HexabitzPlatform/USB-FTDI/README.md

# USB-FTDI
Hexabitz 3.3V/0.5A USB to FTDI Cable Circuit Hardware Design
