HexabitzPlatform/USB-FTDI/Rleased/BOM/USB_FTDI.xlsx

 |  | www.hexabitz.com info@hexabitz.com |  | Bill Of Materials
Customer | Hexabitz | Revision | 1
Project | Hexabitz Kits | Date | 2024-08-31
Board | USB to FTDI with 3.3V/1A | Notes
Designator | Description | Manufacturer Part Number | Manufacturer | Octopart Url | Quantity
J1 | 4 Position 30 VAC 3 A USB Type A 2.0 Right Angle Receptacle USB Connector | USB1061-GF-L-A | GCT | https://octopart.com/usb1061-gf-l-a-global+connector+technology-51853460?r=sp | 1
C8 | CAP 50V 10nF KEMET Multilayer Ceramic Capacitors MLCC-SMD/ | C0603C103K5RACTU | KEMET | https://octopart.com/c0603c103k5ractu-kemet-133094?r=sp&s=R_iPBxLnSmGqhkU2rIMFpg | 1
C6, C7 , C9, C10 | CAP CER 0.1UF 25V X7R 0603 | CGA3E2X8R1E104K080AE | TDK | https://octopart.com/cga3e2x8r1e104k080ae-tdk-68305753?r=sp | 4
C3, C4 | Multilayer Ceramic Capacitor, 47 pF, 50 V, ± 5%, C0G (NP0), 0603 [1608 Metric] | CL10C470JB8NNNC | Samsung | https://octopart.com/cl10c470jb8nnnc-samsung-9299382?r=sp | 2
C2 | CAP CER 1 UF 16V X7R 0805 | CC0805KKX7R7BB105 | YAGEO [VA] | https://octopart.com/cc0805kkx7r7bb105-yageo-8376555?r=sp | 1
C5 | CAP CER 4.7UF 16V X7R 0805 | C0805C475K4RACTU | KEMET [VA] | https://octopart.com/c0805c475k4ractu-kemet-22859922?r=sp | 1
C1 | CAP CERAMIC TOR 100UF 6.3V X5R 20% 1210 | C3225X5R0J107M250AC | TDK | https://octopart.com/c3225x5r0j107m250ac-tdk-25947844?r=spc# | 1
R1, R2 | Thick Film Resistors - SMD 0603 27ohms 5% AEC-Q200 | ERJ-3GEYJ270V | Panasonic | https://octopart.com/erj-3geyj270v-panasonic-55422052?r=sp | 2
R3, R4 | Thick Film Resistors - SMD 0603 270 Ohm 5% Tol | ERJ-3GEYJ271V | Panasonic | https://octopart.com/erj-3geyj271v-panasonic-55560546?r=sp | 2
FB1 | Ferrite Beads Multi-Layer 30Ohm 25% 100MHz 1.5A 50mOhm DCR 0603 | MPZ1608S601ATD25 | TDK | https://octopart.com/search?q=MPZ1608S601ATD25&currency=USD&specs=0 | 1
RXLED | LED Uni-Color Soft Orange 611nm 2-Pin Chip 0603(1608Metric) T/R | VLMO1300-GS08 | Vishay | https://octopart.com/vlmo1300-gs08-vishay-21709200?r=sp# | 1
TXLED | LED Uni-Color Yellow 588nm 2-Pin Chip 0603(1608Metric) T/R | VLMY1300-GS08 | Vishay | https://octopart.com/vlmy1300-gs08-vishay-21709204?r=sp | 1
IC1 | USB Full Speed to Serial UART IC, Includes Oscillator and EEPROM - SSOP-28 | FT232RL-REEL | FTDI | https://octopart.com/ft232rl-reel-ftdi-19172117?r=sp | 1
U1 | Linear Voltage Regulator IC 1 Output 1A SOT-223-4 | LM3940IMP-3.3/NOPB | Texas Instruments | https://octopart.com/lm3940imp-3.3%2Fnopb-texas+instruments-24823014?r=sp | 1
