HexabitzPlatform/USB-FTDI/Documentation/USB_FTDI Schematic.pdf

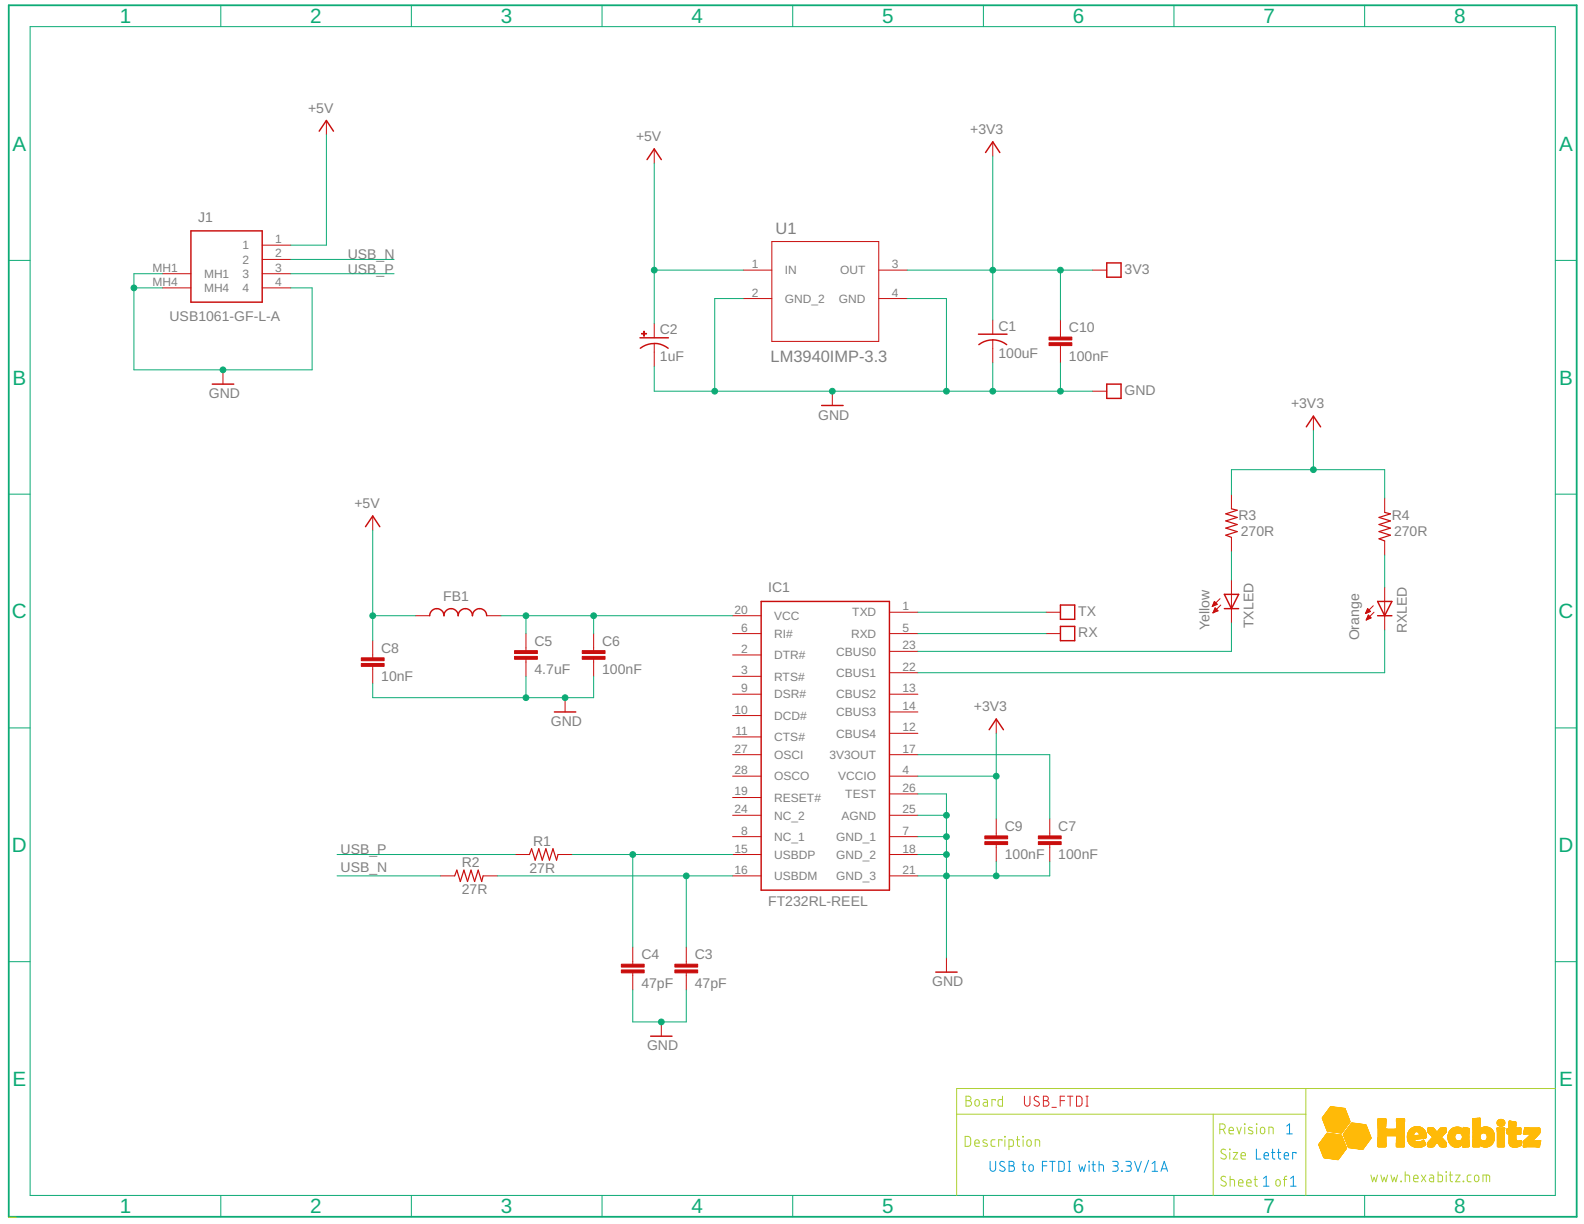
[picture p1: page 1]
