HexabitzPlatform/USB-FTDI/Design/USB_FTDI.brd

## EAGLE design Design/USB_FTDI.brd (2024-09-01)

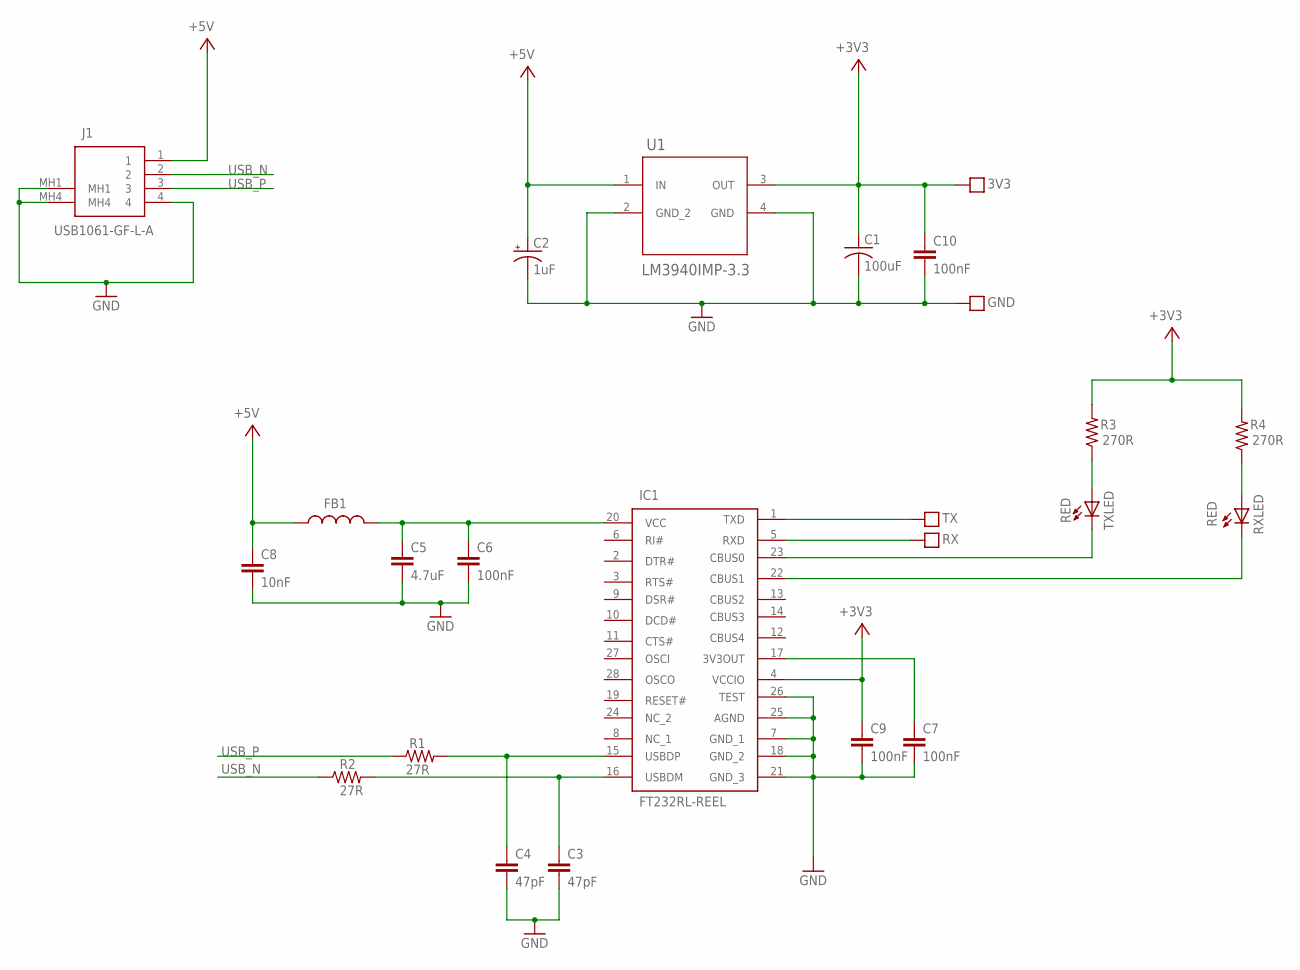
[picture p2: schematic USB_FTDI.sch]

Parts:
3V3: PAD5
C1: 100uF; C-1210
C2: 1uF; C-0805-POL
C3, C4: 47pF; C-0603
C5: 4.7uF; C-0805
C6, C7, C9, C10: 100nF; C-0603
C8: 10nF; C-0603
FB1: FB-0603
GND: PAD5
IC1: FT232RL-REEL; SOP65P778X200-28N
J1: USB1061-GF-L-A; USB1061GFLA
R1, R2: 27R; R-0603
R3, R4: 270R; R-0603
RX: PAD5
RXLED: RED; VLMS1300-GS08
TX: PAD5
TXLED: RED; VLMS1300-GS08
U1: LM3940IMP-3.3; SOT230P696X180-4N

Connections:
+3V3: 3V3.P$1, 3V3.P$2, C1.1, C9.1, C10.1, IC1.4 (VCCIO), R3.2, R4.2, U1.3 (OUT)
+5V: C2.1 (+), C8.1, FB1.1, J1.1, U1.1 (IN)
GND: C1.2, C2.2 (-), C3.2, C4.2, C5.2, C6.2, C7.2, C8.2, C9.2, C10.2, GND.P$1, GND.P$2, IC1.7 (GND_1), IC1.18 (GND_2), IC1.21 (GND_3), IC1.25 (AGND), IC1.26 (TEST), J1.4, J1.MH1, J1.MH4, U1.2 (GND_2), U1.4 (GND)
unnamed: R4.1, RXLED.A
unnamed: R3.1, TXLED.A
unnamed: IC1.1 (TXD), TX.P$1, TX.P$2
unnamed: IC1.5 (RXD), RX.P$1, RX.P$2
unnamed: C5.1, C6.1, FB1.2, IC1.20 (VCC)
unnamed: IC1.23 (CBUS0), TXLED.C
unnamed: IC1.22 (CBUS1), RXLED.C
unnamed: C7.1, IC1.17 (3V3OUT)
USBF_N: C3.1, IC1.16 (USBDM), R2.2
USBF_P: C4.1, IC1.15 (USBDP), R1.2
USB_N: J1.2, R2.1
USB_P: J1.3, R1.1

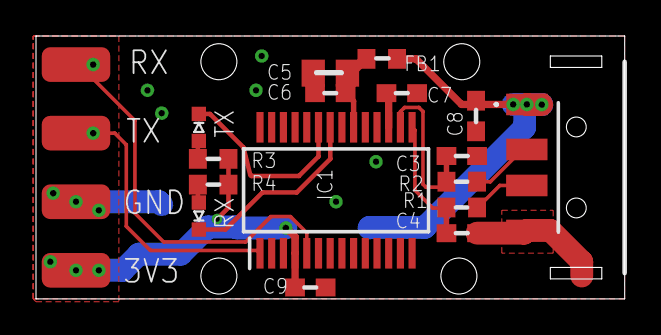
[picture p3: board USB_FTDI.brd from above]

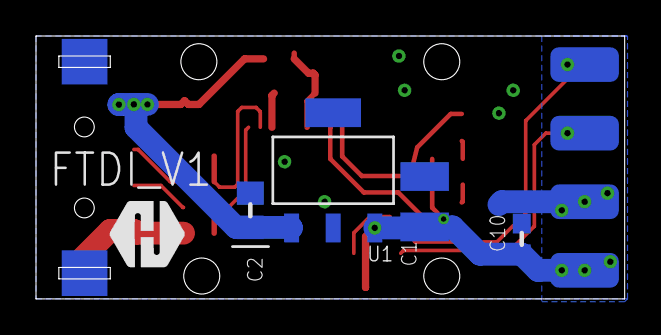
[picture p4: board USB_FTDI.brd from below]

Board: 2 copper layers, 32.7 x 14.6 mm, 25 parts (5 on the bottom side), 15 nets.

Other parts of the board:
TRIMBLE-LOGO1: HEXA-LOGO
