HexabitzPlatform/USB-FTDI/(commit log)

2024-07-20 Add the V0 files
    [USB_FTDI.brd, USB_FTDI.sch, USB_FTDI.xlsx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]
2024-09-01 - Connect the VCCIO pin of the FTDI IC to the 3.3V - Improve the layout to offer better thermal conductivity for the LDO
    [USB_FTDI.brd, USB_FTDI.sch, USB_FTDI.xlsx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]
